fabriciotm/nonSNES/(commit log)

2025-11-12 add back old reset switch
    [nonSNES.kicad_sch]
2025-12-06 1mm width
